SoMuchHat/LED_Watch/Hardware/Layout/LED_Watch/layout_draft1.png

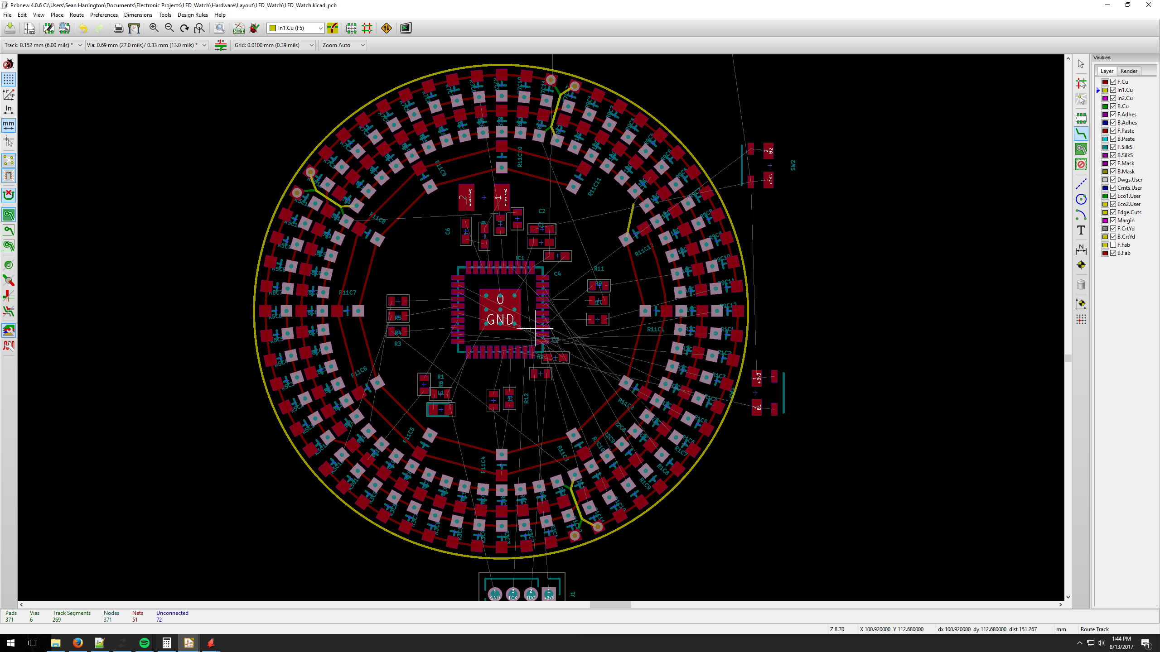
Hardware/Layout/LED_Watch/layout_draft1.png
