SoMuchHat/LED_Watch/Hardware/BOM/LED_Watch_BOM.xlsx

Part | Manf. | P/N | Quantity | Notes | Compatibility for v1.1 | Checked in v1.1
Capacitor |  | C0603C0G1E090D030BA | 2 | Crystal caps | NO
MCU | TI | MSP430FR5721 | 1 |  | Yes
Capacitor | Murata | GRM033R71E471KA01D | 1 | VCORE Capacitance
Capacitor | MENA | 490-1318-1-ND | 2? | 0.1 uF decoupling
Capacitor |  | 445-8919-1-ND (http://www.digikey.com/scripts/DkSearch/dksus.dll?Detail&itemSeq=178538991&uq=635760440624849824) |  | 10 uF decoupling
LED | OSRAM | LS Q976-NR-1 | 132 | Purchase extras? | Yes
Resistor | Yageo | RC0201JR-0747KL | 1 | Pullup - RST | Yes
Holder | Linx Tech | BAT-HLD-012-SMT-ND | 1 | Battery holder for CR1216 cell | Yes
Resistor | Yageo | 311-200NCT-ND | 12 | Current limiting resistors for LEDs | Yes | Yes
Capacitor |  | 490-6125-1-ND | 1 |  | Yes
Crystal | Abracon | 535-9542-1-ND | 1 |  | Yes
Tactile Switch | Panasonic | P16849TR-ND | 2 | Tactile push buttons to control watch | Yes
LED | Panasonic | LNJ247W82RACT-ND | 1 | PM indictor LED | Yes | Yes
Capacitor | JTI | 712-1220-1-ND | 2 | Crystal caps | Yes | Yes
Capacitor |  | ? | 1 | 0402 2.2 nF Decoupling
