SoMuchHat/LED_Watch/Elecrow-Quote-Request.xlsx

Premium PCB Service Technology Requirement
PCB Name & Version
PCB Material PCB板材： | (Rigid)FR－4 Flex | PCB Qty PCB 数量 | （ 5 ）
PCB Size PCB大小： | cm mm inch | ( 1.42 ) × ( 1.45 )
PCB Layer PCB层数： | 2 | 4 | other:( )
Thickness PCB厚度： | 0.8mm | 1.2mm | other:( )
 | 1mm | 1.6mm
Copper Weight 铜厚： | 1oz | 2oz | other:( )
PCB Colour 阻焊颜色： | Green 绿色 | White 白色 | Black 黑色
 | Red 红色 | Blue 蓝色 | other:( )
Silkscreen 字符颜色： | White 白色 | Black 黑色 | other:( )
Pads Finished 焊盘喷镀： | (Hasl-lead free) 无铅喷锡 | (Hasl) 含铅喷锡 | (ENIG) 沉镍金
Via solder mask 阻焊覆盖： | solder mask cover 过孔盖油 | solder mask opening 过孔开窗
Minimum trace/space (mm) 最小线宽 | 0.127 | Minimum hole size (mm) 最小孔径 | 0.254
Special requirements 特殊工艺： | Yes | (Put requirements here)
价格/Price | Premium PCB service | PCB with normal price | The PCB with normal price is listed online, If there isn't a choice meets your requirement, get quotation off-line.
Comment:
Shipping Address | 31195 Wellington Dr. Apt. 26310- Novi- 48377- Michigan- United States Building- street- city- city post code- province - Country
