SoMuchHat/LED_Watch/Hardware/CAD/pcb-holder.FCStd

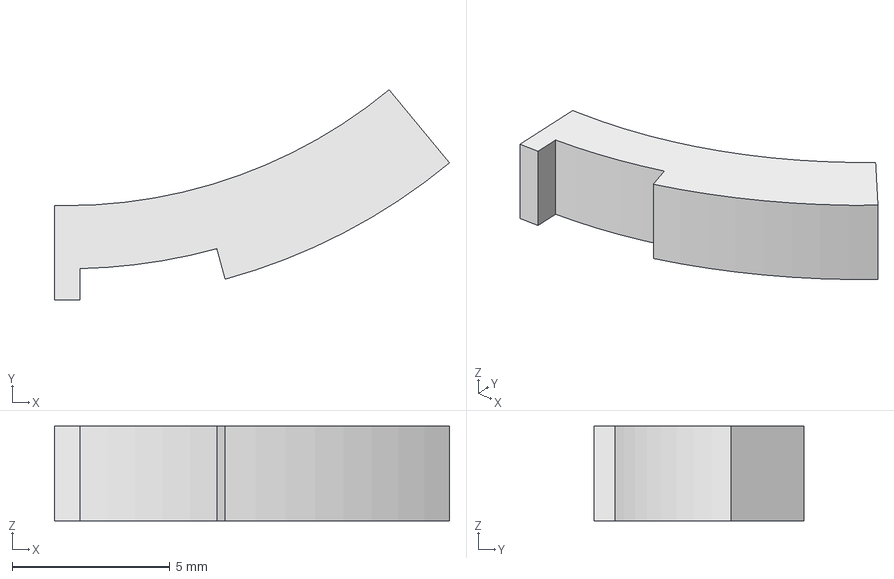
[picture p2: CAD file, 2018-08-01]
Hardware/CAD/pcb-holder.FCStd
12.5 x 6.66 x 3.00 mm
