SoMuchHat/LED_Watch/Hardware/Layout/LED_Watch/test.dxf

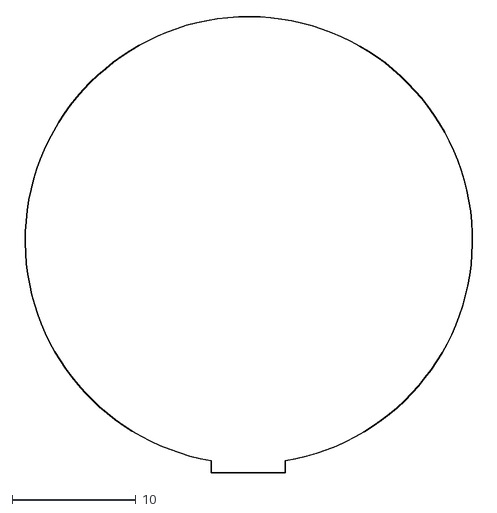
[picture p3: CAD file, 2018-08-01]
Hardware/Layout/LED_Watch/test.dxf
37.5 x 36.8
