SoMuchHat/LED_Watch/Hardware/CAD/pcb-holder-v5.FCStd

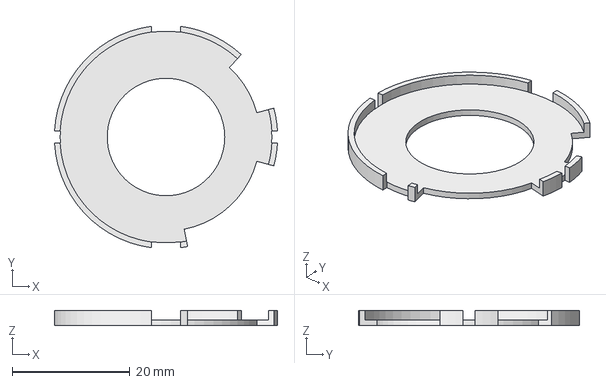
[picture p4: CAD file, 2018-08-01]
Hardware/CAD/pcb-holder-v5.FCStd
37.9 x 37.7 x 2.60 mm
