SoMuchHat/LED_Watch/Hardware/Layout/LED_Watch/board-outline.FCStd

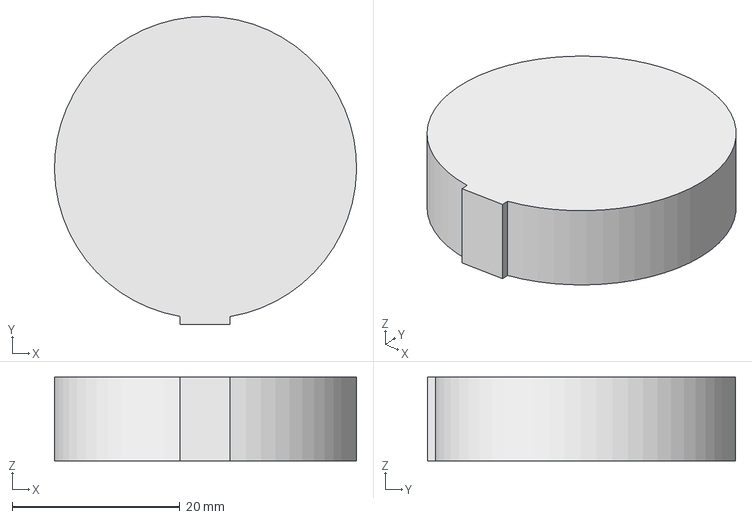
[picture p5: CAD file, 2018-08-01]
Hardware/Layout/LED_Watch/board-outline.FCStd
36.1 x 36.8 x 10.0 mm
