SoMuchHat/LED_Watch/(list of files, cad)

Other CAD files:
LED_Watch/Debug/optimizerAssistant/opt_for_speed__1/main.obj
LED_Watch/Debug/optimizerAssistant/opt_for_speed__3/main.obj
LED_Watch/Debug/optimizerAssistant/opt_level__1/main.obj
Software/LED_Watch/Debug/optimizerAssistant/opt_for_speed__5/main.obj
Software/LED_Watch/Debug/optimizerAssistant/opt_level__0/main.obj
Software/LED_Watch/Debug/optimizerAssistant/opt_level__1/main.obj
LED_Watch/Debug/optimizerAssistant/opt_for_speed__0/main.obj
LED_Watch/Debug/optimizerAssistant/opt_for_speed__2/main.obj
LED_Watch/Debug/optimizerAssistant/opt_for_speed__4/main.obj
LED_Watch/Debug/optimizerAssistant/opt_for_speed__5/main.obj
LED_Watch/Debug/optimizerAssistant/opt_level__0/main.obj
LED_Watch/Debug/optimizerAssistant/opt_level__2/main.obj
LED_Watch/Debug/optimizerAssistant/opt_level__3/main.obj
LED_Watch/Debug/optimizerAssistant/opt_level__4/main.obj
LED_Watch/Debug/optimizerAssistant/opt_level__off/main.obj
Software/LED_Watch/Debug/optimizerAssistant/opt_for_speed__0/main.obj
Software/LED_Watch/Debug/optimizerAssistant/opt_for_speed__1/main.obj
Software/LED_Watch/Debug/optimizerAssistant/opt_for_speed__2/main.obj
Software/LED_Watch/Debug/optimizerAssistant/opt_for_speed__3/main.obj
Software/LED_Watch/Debug/optimizerAssistant/opt_for_speed__4/main.obj
Software/LED_Watch/Debug/optimizerAssistant/opt_level__2/main.obj
Software/LED_Watch/Debug/optimizerAssistant/opt_level__3/main.obj
Software/LED_Watch/Debug/optimizerAssistant/opt_level__4/main.obj
Software/LED_Watch/Debug/optimizerAssistant/opt_level__off/main.obj
LED_Watch/Debug/optimizerAssistant/opt_for_speed__0/led_controller.obj
LED_Watch/Debug/optimizerAssistant/opt_for_speed__2/led_controller.obj
LED_Watch/Debug/optimizerAssistant/opt_for_speed__4/led_controller.obj
LED_Watch/Debug/optimizerAssistant/opt_for_speed__5/led_controller.obj
LED_Watch/Debug/optimizerAssistant/opt_level__0/led_controller.obj
LED_Watch/Debug/optimizerAssistant/opt_level__2/led_controller.obj
LED_Watch/Debug/optimizerAssistant/opt_level__3/led_controller.obj
LED_Watch/Debug/optimizerAssistant/opt_level__4/led_controller.obj
LED_Watch/Debug/optimizerAssistant/opt_level__off/led_controller.obj
Software/LED_Watch/Debug/optimizerAssistant/opt_for_speed__0/led_controller.obj
Software/LED_Watch/Debug/optimizerAssistant/opt_for_speed__1/led_controller.obj
Software/LED_Watch/Debug/optimizerAssistant/opt_for_speed__2/led_controller.obj
Software/LED_Watch/Debug/optimizerAssistant/opt_for_speed__3/led_controller.obj
Software/LED_Watch/Debug/optimizerAssistant/opt_for_speed__4/led_controller.obj
Software/LED_Watch/Debug/optimizerAssistant/opt_level__2/led_controller.obj
Software/LED_Watch/Debug/optimizerAssistant/opt_level__3/led_controller.obj
Software/LED_Watch/Debug/optimizerAssistant/opt_level__4/led_controller.obj
Software/LED_Watch/Debug/optimizerAssistant/opt_level__off/led_controller.obj
LED_Watch/Debug/optimizerAssistant/opt_for_speed__1/led_controller.obj
LED_Watch/Debug/optimizerAssistant/opt_for_speed__3/led_controller.obj
LED_Watch/Debug/optimizerAssistant/opt_level__1/led_controller.obj
Software/LED_Watch/Debug/optimizerAssistant/opt_for_speed__5/led_controller.obj
Software/LED_Watch/Debug/optimizerAssistant/opt_level__0/led_controller.obj
Software/LED_Watch/Debug/optimizerAssistant/opt_level__1/led_controller.obj
Hardware/CAD/pcb-holder-v2.FCStd
Hardware/CAD/pcb-holder-v2.stl
Hardware/CAD/pcb-holder-v3.FCStd
Hardware/CAD/pcb-holder-v3.stl
Hardware/CAD/pcb-holder-v4.FCStd
Hardware/CAD/pcb-holder-v4.stl
Hardware/CAD/pcb-holder-v5.stl
Hardware/CAD/pcb-holder.stl
