SoMuchHat/LED_Watch/Hardware/Layout/Issues.txt

- Missing ground connections between crystal capacitors
- Two grounds are separated. MCU is not connected to the ground plane
