SoMuchHat/LED_Watch/Hardware/Layout/LED_Watch/LED_Watch.kicad_pcb

## KiCad design Hardware/Layout/LED_Watch/LED_Watch.kicad_pcb (2018-08-01)

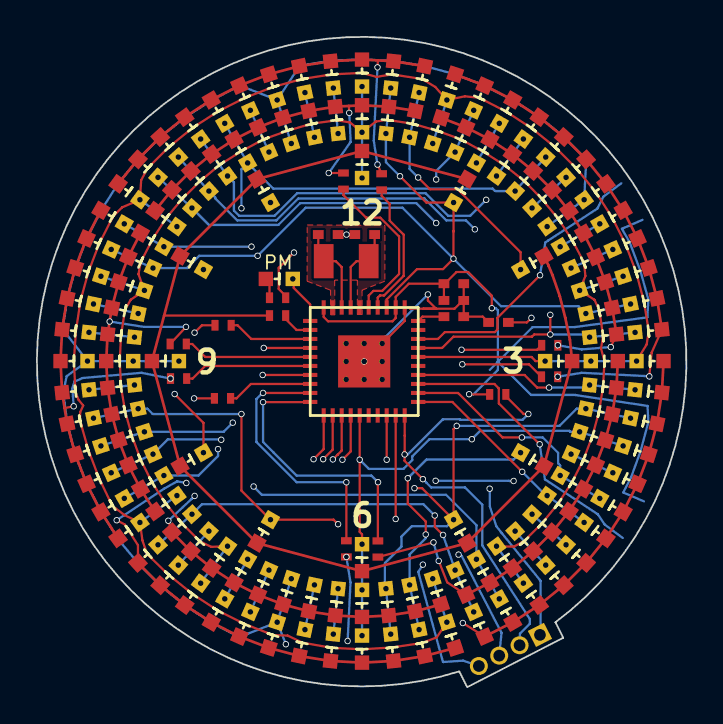
[picture p7: board LED_Watch.kicad_pcb from above]

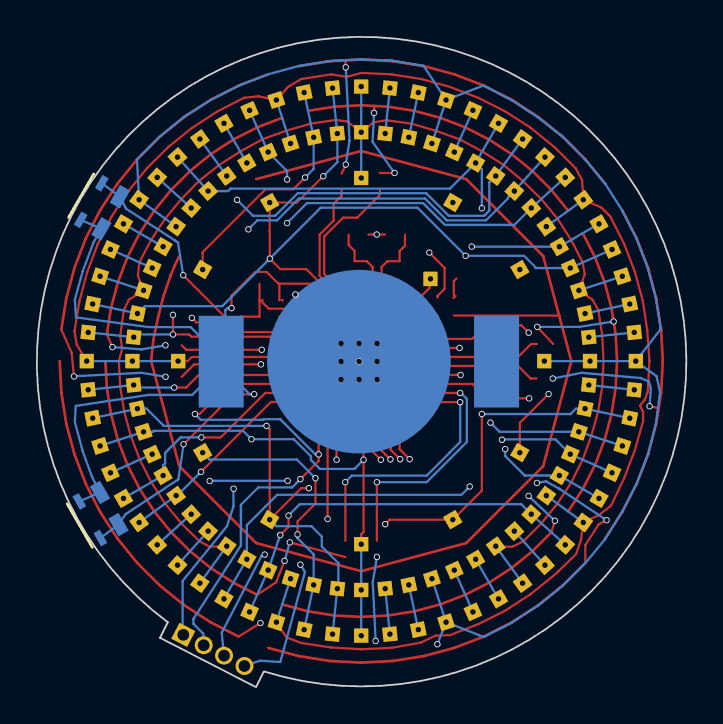
[picture p8: board LED_Watch.kicad_pcb from below]

Board: 4 copper layers, 36.1 x 36.1 mm, 158 parts (3 on the bottom side), 46 nets.

Parts:
BT1: CR1216; BAT-HLD-012-SMT
C1: 10uF; C_0402_NoSilk
C2: 0.1uF; C_0402_NoSilk
C3: 1.1nF; C_0402_NoSilk
C4: 470nF; C_0402_NoSilk
C5, C6: 22pF; C_0402_NoSilk
IC1: MSP430FR5721
J1: CONN_01X04; Pin_Header_Straight_1x04_Pitch1.27mm
L1: LED; LSQ976
R1, R3, R4, R5, R6, R7, R8, R9, R10, R11, R12, R13: 200; R_0402_NoSilk
R1C1, R1C2, R1C3, R1C4, R1C5, R1C6, R1C7, R1C8, R1C9, R1C10, R1C11, R1C12, R2C1, R2C2, R2C3, R2C4, R2C5, R2C6, R2C7, R2C8, R2C9, R2C10, R2C11, R2C12, R3C1, R3C2, R3C3, R3C4, R3C5, R3C6, R3C7, R3C8, R3C9, R3C10, R3C11, R3C12, R4C1, R4C2, R4C3, R4C4, R4C5, R4C6, R4C7, R4C8, R4C9, R4C10, R4C11, R4C12, R5C1, R5C2, R5C3, R5C4, R5C5, R5C6, R5C7, R5C8, R5C9, R5C10, R5C11, R5C12, R6C1, R6C2, R6C3, R6C4, R6C5, R6C6, R6C7, R6C8, R6C9, R6C10, R6C11, R6C12, R7C1, R7C2, R7C3, R7C4, R7C5, R7C6, R7C7, R7C8, R7C9, R7C10, R7C11, R7C12, R8C1, R8C2, R8C3, R8C4, R8C5, R8C6, R8C7, R8C8, R8C9, R8C10, R8C11, R8C12, R9C1, R9C2, R9C3, R9C4, R9C5, R9C6, R9C7, R9C8, R9C9, R9C10, R9C11, R9C12, R10C1, R10C2, R10C3, R10C4, R10C5, R10C6, R10C7, R10C8, R10C9, R10C10, R10C11, R10C12, R11C1, R11C2, R11C3, R11C4, R11C5, R11C6, R11C7, R11C8, R11C9, R11C10, R11C11, R11C12: LED; LSQ976
R2: 47k; R_0402_NoSilk
SW1, SW2: SW_Push; EVP-AVAA1A
Y1: Crystal; ABS07

Connections:
+3V3: BT1.1, C1.1, C2.1, IC1.32, IC1.40, J1.1, R2.1, SW1.1, SW2.2
/B1: IC1.28, SW1.2
/B2: IC1.23, SW2.1
/COL1: IC1.26, R1C1.2, R2C1.2, R3C1.2, R4C1.2, R5C1.2, R6C1.2, R7C1.2, R8C1.2, R9C1.2, R10C1.2, R11C1.2
/COL2: IC1.24, R1C2.2, R2C2.2, R3C2.2, R4C2.2, R5C2.2, R6C2.2, R7C2.2, R8C2.2, R9C2.2, R10C2.2, R11C2.2
/COL3: IC1.18, R1C3.2, R2C3.2, R3C3.2, R4C3.2, R5C3.2, R6C3.2, R7C3.2, R8C3.2, R9C3.2, R10C3.2, R11C3.2
/COL4: IC1.15, R1C4.2, R2C4.2, R3C4.2, R4C4.2, R5C4.2, R6C4.2, R7C4.2, R8C4.2, R9C4.2, R10C4.2, R11C4.2
/COL5: IC1.12, R1C5.2, R2C5.2, R3C5.2, R4C5.2, R5C5.2, R6C5.2, R7C5.2, R8C5.2, R9C5.2, R10C5.2, R11C5.2
/COL6: IC1.22, R1C6.2, R2C6.2, R3C6.2, R4C6.2, R5C6.2, R6C6.2, R7C6.2, R8C6.2, R9C6.2, R10C6.2, R11C6.2
/COL7: IC1.21, R1C7.2, R2C7.2, R3C7.2, R4C7.2, R5C7.2, R6C7.2, R7C7.2, R8C7.2, R9C7.2, R10C7.2, R11C7.2
/COL8: IC1.14, R1C8.2, R2C8.2, R3C8.2, R4C8.2, R5C8.2, R6C8.2, R7C8.2, R8C8.2, R9C8.2, R10C8.2, R11C8.2
/COL9: IC1.13, R1C9.2, R2C9.2, R3C9.2, R4C9.2, R5C9.2, R6C9.2, R7C9.2, R8C9.2, R9C9.2, R10C9.2, R11C9.2
/COL10: IC1.11, R1C10.2, R2C10.2, R3C10.2, R4C10.2, R5C10.2, R6C10.2, R7C10.2, R8C10.2, R9C10.2, R10C10.2, R11C10.2
/COL11: IC1.33, R1C11.2, R2C11.2, R3C11.2, R4C11.2, R5C11.2, R6C11.2, R7C11.2, R8C11.2, R9C11.2, R10C11.2, R11C11.2
/COL12: IC1.27, R1C12.2, R2C12.2, R3C12.2, R4C12.2, R5C12.2, R6C12.2, R7C12.2, R8C12.2, R9C12.2, R10C12.2, R11C12.2
/PM_LED: IC1.1, L1.2
/ROW1: IC1.9, R3.1
/ROW2: IC1.10, R4.1
/ROW3: IC1.3, R5.1
/ROW4: IC1.8, R6.1
/ROW5: IC1.6, R7.1
/ROW6: IC1.5, R8.1
/ROW7: IC1.34, R9.1
/ROW8: IC1.35, R10.1
/ROW9: IC1.7, R11.1
/ROW10: IC1.4, R12.1
/ROW11: IC1.2, R13.1
/TCK: IC1.19, J1.3
/TDO: C3.1, IC1.20, J1.2, R2.2
GND: BT1.2, C1.2, C2.2, C3.2, C4.2, C5.1, C6.1, IC1.0, IC1.31, J1.4, R1.2
unnamed: C4.1, IC1.30
unnamed: C5.2, IC1.37, Y1.1
unnamed: C6.2, IC1.38, Y1.2
unnamed: IC1.36, IC1.39
unnamed: L1.1, R1.1
unnamed: R1C1.1, R1C2.1, R1C3.1, R1C4.1, R1C5.1, R1C6.1, R1C7.1, R1C8.1, R1C9.1, R1C10.1, R1C11.1, R1C12.1, R3.2
unnamed: R2C1.1, R2C2.1, R2C3.1, R2C4.1, R2C5.1, R2C6.1, R2C7.1, R2C8.1, R2C9.1, R2C10.1, R2C11.1, R2C12.1, R4.2
unnamed: R3C1.1, R3C2.1, R3C3.1, R3C4.1, R3C5.1, R3C6.1, R3C7.1, R3C8.1, R3C9.1, R3C10.1, R3C11.1, R3C12.1, R5.2
unnamed: R4C1.1, R4C2.1, R4C3.1, R4C4.1, R4C5.1, R4C6.1, R4C7.1, R4C8.1, R4C9.1, R4C10.1, R4C11.1, R4C12.1, R6.2
unnamed: R5C1.1, R5C2.1, R5C3.1, R5C4.1, R5C5.1, R5C6.1, R5C7.1, R5C8.1, R5C9.1, R5C10.1, R5C11.1, R5C12.1, R7.2
unnamed: R6C1.1, R6C2.1, R6C3.1, R6C4.1, R6C5.1, R6C6.1, R6C7.1, R6C8.1, R6C9.1, R6C10.1, R6C11.1, R6C12.1, R8.2
unnamed: R7C1.1, R7C2.1, R7C3.1, R7C4.1, R7C5.1, R7C6.1, R7C7.1, R7C8.1, R7C9.1, R7C10.1, R7C11.1, R7C12.1, R9.2
unnamed: R8C1.1, R8C2.1, R8C3.1, R8C4.1, R8C5.1, R8C6.1, R8C7.1, R8C8.1, R8C9.1, R8C10.1, R8C11.1, R8C12.1, R10.2
unnamed: R10C1.1, R10C2.1, R10C3.1, R10C4.1, R10C5.1, R10C6.1, R10C7.1, R10C8.1, R10C9.1, R10C10.1, R10C11.1, R10C12.1, R12.2
unnamed: R9C1.1, R9C2.1, R9C3.1, R9C4.1, R9C5.1, R9C6.1, R9C7.1, R9C8.1, R9C9.1, R9C10.1, R9C11.1, R9C12.1, R11.2
unnamed: R11C1.1, R11C2.1, R11C3.1, R11C4.1, R11C5.1, R11C6.1, R11C7.1, R11C8.1, R11C9.1, R11C10.1, R11C11.1, R11C12.1, R13.2
