SoMuchHat/LED_Watch/Hardware/Layout/LED_Watch/LED_Matrix.sch

## KiCad design Hardware/Layout/LED_Watch/LED_Matrix.sch (2018-08-01)

Schematic: LED_Matrix.sch

Parts:
R1C1, R1C2, R1C3, R1C4, R1C5, R1C6, R1C7, R1C8, R1C9, R1C10, R1C11, R1C12, R2C1, R2C2, R2C3, R2C4, R2C5, R2C6, R2C7, R2C8, R2C9, R2C10, R2C11, R2C12, R3C1, R3C2, R3C3, R3C4, R3C5, R3C6, R3C7, R3C8, R3C9, R3C10, R3C11, R3C12, R4C1, R4C2, R4C3, R4C4, R4C5, R4C6, R4C7, R4C8, R4C9, R4C10, R4C11, R4C12, R5C1, R5C2, R5C3, R5C4, R5C5, R5C6, R5C7, R5C8, R5C9, R5C10, R5C11, R5C12, R6C1, R6C2, R6C3, R6C4, R6C5, R6C6, R6C7, R6C8, R6C9, R6C10, R6C11, R6C12, R7C1, R7C2, R7C3, R7C4, R7C5, R7C6, R7C7, R7C8, R7C9, R7C10, R7C11, R7C12, R8C1, R8C2, R8C3, R8C4, R8C5, R8C6, R8C7, R8C8, R8C9, R8C10, R8C11, R8C12, R9C1, R9C2, R9C3, R9C4, R9C5, R9C6, R9C7, R9C8, R9C9, R9C10, R9C11, R9C12, R10C1, R10C2, R10C3, R10C4, R10C5, R10C6, R10C7, R10C8, R10C9, R10C10, R10C11, R10C12, R11C1, R11C2, R11C3, R11C4, R11C5, R11C6, R11C7, R11C8, R11C9, R11C10, R11C11, R11C12: LED; LSQ976
R3, R4, R5, R6, R7, R8, R9, R10, R11, R12, R13: 200; R_0402_NoSilk
