SoMuchHat/LED_Watch/Hardware/Layout/LED_Watch/LED_Watch.sch

## KiCad design Hardware/Layout/LED_Watch/LED_Watch.sch (2018-08-01)

Schematic: LED_Watch.sch

Parts:
BT1: CR1216; BAT-HLD-012-SMT
C1: 10uF; C_0402_NoSilk
C2: 0.1uF; C_0402_NoSilk
C3: 1.1nF; C_0402_NoSilk
C4: 470nF; C_0402_NoSilk
C5, C6: 22pF; C_0402_NoSilk
IC1: MSP430FR5721
J1: CONN_01X04; Pin_Header_Straight_1x04_Pitch1.27mm
L1: LED; LSQ976
R1: 200; R_0402_NoSilk
R2: 47k; R_0402_NoSilk
SW1, SW2: SW_Push; EVP-AVAA1A
Y1: Crystal; ABS07
