SoMuchHat/LED_Watch/(commit log)

2015-08-17 Initial git commit.
    Schematic v0.1
    Board v0.1 (WIP)
    Documentation upload
    [LED_Watch_BOM.xlsx, led_watch.brd, led_watch.sch]
2015-08-18 Added battery holder documentation Large board layout redesign to prevent vias shorting to pos. battery terminal (WIP)
    [LED_Watch_BOM.xlsx, led_watch.brd, led_watch.sch]
2015-08-19 Finished laying out board traces. Tactile edge switches may need moved. Added tactile switch datasheet
    [led_watch.brd, led_watch.sch]
2015-08-20 Board layout finished (v1.0) Gerbers generated
    [LED_Watch_BOM.xlsx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]
2015-08-21 Started software. GPIO initialization setup.
    [LED_Watch_BOM.xlsx]
2015-08-26 Updated BOM with correct items Added LED Controller.c to easily control which LED is on.
    [LED_Watch_BOM.xlsx]
2015-08-26 Added in addition initialization code (clock and RTC) along with RTC and button ISRs
2015-08-27 Added Timer A for button debouncing, expanded button functionality
2015-08-28 Expanded hours array to include PM hours and added PM LED control in all hour functions Added ShowTime code Added SetTime code and functionality to blink current hour/min/sec being changed. Added ini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
2015-08-30 Fixed capacitor values for crystal (9 pF -> 22 pF)
    [led_watch.brd, led_watch.sch]
2015-08-30 Modified busy waiting while loops to sleep + interrupt. Fixed bug where blink variable would be enabled but never disabled.
    [main.c]
2017-02-23 v1.1 board layout attempt 1
    [led_watch.brd, led_watch.sch]
2017-02-23 Flipped everything... could have just flipped MCU. Committing just in case
    [led_watch.brd, led_watch.sch]
2017-02-27 Improved crystal board layout, added reverse voltage protection with schottky diode. Fixed incorrect capacitor package sizes.
    [LED_Watch_BOM.xlsx, led_watch.brd, led_watch.sch]
2017-03-16 Expanded board size slightly to ensure switch contacts do not touch LED contacts. Added more silkscreen, fixed size of PM LED
    [LED_Watch_BOM.xlsx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]
2017-08-26 Transition to KiCAD for hardware design.
    [LED_Matrix.sch, LED_Watch.kicad_pcb, LED_Watch.sch]
2017-08-28 Design of v1.1 complete. New features: LED light sensing capabilities. Enlarged radius of board slightly. Added "key" for 0.1" pin headers used for programming and to prevent board from rotating in e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
    [Elecrow-Quote-Request.xlsx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]
2017-09-30 Working for version of the software that makes use of external oscillator, RTC, and has two different disiplay modes. Does not currently attempt to sleep. Next features: Sleeping to improve energy us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
    [led_controller.c, main.c]
2017-10-30 Reduced code size, blinking now working, set time now working. Need to improve button debouncing.
2017-11-02 Complete refactoring of how LEDs are controlled. Now using what I would call "instruction" jump table. Code size reduced, a few bugs were introduced with this change. The dim LED artifact is occuring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
    [led_controller.obj, main.obj]
2017-11-04 Fixed dimming light, index corruption, and led jump table to not skip hour 4
    [led_controller.c, main.c]
2018-02-04 Fixed missing connection between osc and gnd. Fixed disconnected GNDs. Need to fix PM LED to be different LED with appropriate ratings
    [LED_Watch.kicad_pcb, LED_Watch.sch]
2018-02-04 Changed PM LED to be the same LED package as others
    [LED_Watch.kicad_pcb]
2018-02-04 Moved debug headers to an offset angle due to watch housing interference.
    [LED_Watch.kicad_pcb, LED_Watch.sch]
2018-03-18 Current commit before attempting solution to LEDs not updating during RTC update.
2018-03-20 Fixed LEDs turning off briefly every second. Fixed incorrect LEDs lighting up in display mode 2. Fixed 1 second blink for change time mode.
    [main.c]
2018-04-06 Fixed modules so system now enters LPM3.5 successfully and wakes
    [main.c]
2018-04-07 Fixed PM LED not showing when in DISPLAY_MODE_2. Cleaned code
    [main.c]
2018-04-08 Added light detection and LED dimming functionality
2018-08-01 Updated firmware for v1.1
    [led_controller.obj, main.obj]
2018-08-01 Updated PCB to fix last issues with v1.1. PCB changes tested and fully functional
    [LED_Watch-B.Cu.gbl, LED_Watch-B.Mask.gbs, LED_Watch-B.SilkS.gbo, LED_Watch-Edge.Cuts.gm1, LED_Watch-F.Cu.gtl, LED_Watch-F.Mask.gts, LED_Watch-F.SilkS.gto, LED_Watch.drl]
